curiousinventor/VMeter/Hardware/superpro_with_adapter_and_IC.jpg

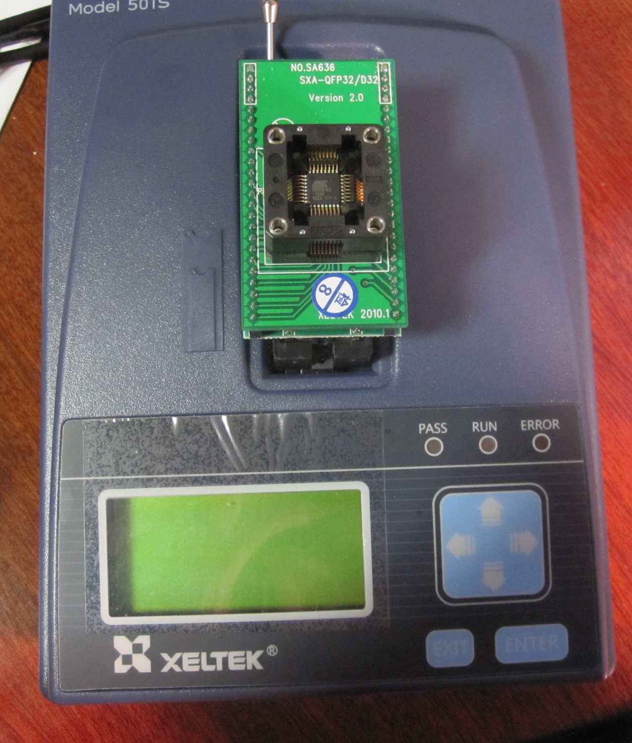
Hardware/superpro_with_adapter_and_IC.jpg
