curiousinventor/VMeter/Hardware/vmeter_fuse_settings.png

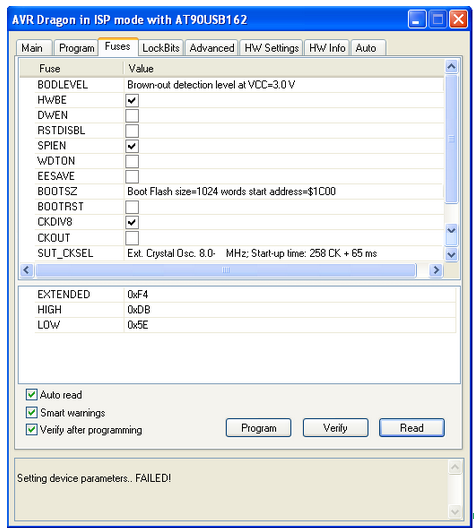
Hardware/vmeter_fuse_settings.png
