curiousinventor/VMeter/Hardware/vmeter_isp_connections.jpg

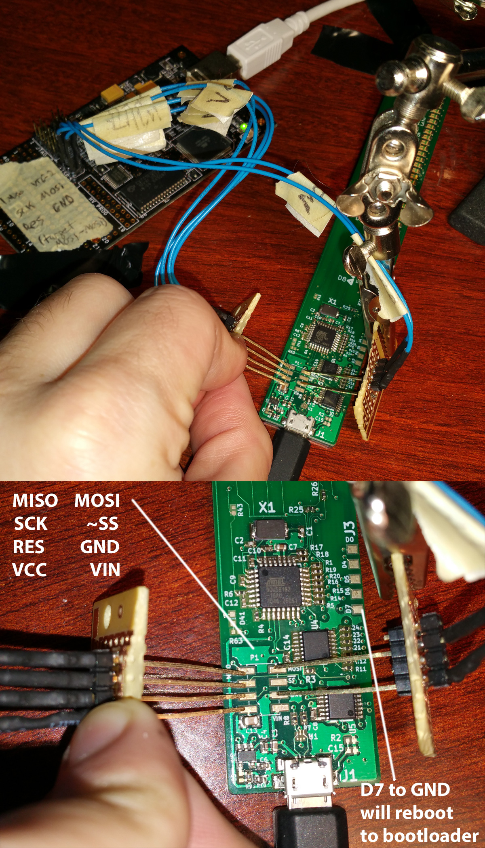
Hardware/vmeter_isp_connections.jpg
