curiousinventor/VMeter/Hardware/VMeter BOM Electrical v0.3n.xlsx

qty | desc | package | designators | dist | dist part num | man | man # | pins / part | total pins
38 | blue backfire leds | 1206 reverse | D6,D5,D3,D2,D1,D4,D7,D9,D14, D15,D16,D17,D18,D19,D20,D21, D22,D23,D24,D25,D26,D27,D28, D10,D11,D12,D40,D39,D38,D37, D36,D35,D32,D31,D30,D29,D13,D8 | digi / mouser | 754-1447-1-ND, mouser: 604-APTR3216QBC/D |  | APTR3216QBC/D | 2 | 76
2 | 8 bit shift register | 16TSSOP | U5,U4 | digikey | MC74HC595ADTR2GOSCT-ND |  | MC74HC595ADTR2G | 16 | 32
1 | AT90USB162-16AU-ND | 32-TQFP | U3 | digikey | AT90USB162-16AU-ND |  | AT90USB162-16AU | 32 | 32
7 | .1uF ceramic caps | 402 | C11,C10,C9,C8,C6,C4,C14 | digi | 311-1047-1-ND |  |  | 2 | 14
2 | 22 ohm res for USB lines | 402 | R8,R7 | digi | 311-22JRCT-ND |  |  | 2 | 4
1 | 10k resistor | 402 | R1 | digi | RMCF0402JT10K0CT-ND |  |  | 2 | 2
1 | 470k res, | 402 | R4 | digi | 311-470KJRCT-ND |  |  | 2 | 2
1 | 4.7nF, X7R important | 402 | C12 | digi | 445-1259-1-ND |  |  | 2 | 2
8 | 560 resistor | 402 | R14,R15,R16,R17,R18,R19,R20,R5 | digi | RMCF0402JT560RCT-ND |  |  | 2 | 16
1 | 10uF caps | 805 | C13 | digi | 311-1355-1-ND |  |  | 2 | 2
2 | 1uF 402 | 402 | C7,C3 | digi | 587-1454-1-ND |  |  | 2 | 4
1 | adj vreg | SOT-23 | U2 | mouser | 701-SP6201EM5-L |  | SP6201EM5-L | 5 | 5
1 | usb micro | smd | J1 | digi | H11634CT-ND, mouse: 798-ZX62-B-5PA11 |  |  | 9 | 9
1 | 8 MHz crystal, small height | smd | X1 | digi | 644-1132-1-ND, smaller version, need to update gerbers |  |  | 2 | 2
2 | 12 pF | 402 | C2,C1 | digi | 311-1016-1-ND |  |  | 2 | 4
1 | 3.48k, 1% | 402 | R10 | digikey | P3.48KLCT-ND, backup: RMCF0402FT3K48CT-ND |  |  | 2 | 2
8 | 150 ohms | 402 | R3,R11,R12,R13,R21,R22,R23,R24 |  | RMCF0402JT150RCT-ND |  |  | 2 | 16
1 | 1k | 402 | R6 |  | RMCF0402JT1K00CT-ND |  |  | 2 | 2
1 | 7.5k | 402 | R9 |  | 311-7.5KJRCT-ND |  |  | 2 | 2
14 | 3.3k | 603 | R30,R31,R32,R33,R34,R35, R36,R29,R37,R38,R39, R40,R41,R28 | digi | P3.3KGTR-ND | panasonic | ERJ-3GEYJ332V | 2 | 28
2 | 150 ohm ferrite | 402 | R25, R26 | mouser | 710-7427927115 | Wurth | 7427927115 | 2
94 | totals |  |  |  |  |  |  | total pins | 256
