curiousinventor/VMeter/Hardware/VMeter BOM Mechanical v0.3n.xlsx

desc | source | part number
assembled pcb | mfr
24x18" of gray acrylic - solar tint, trucast 2064, .060in, 48x72 cut to 24x18 nominal, | acplasticsinc.com
48x96" black acrylic sheet, 2025, .125in, cut to nominal 24x16 | acplasticsinc.com
apply transfer tape, laser cutting & silk screen (epoxy white) | laserexcel.com
3M 467MP Adhesive Transfer Tape -00-021200-68158-5 12" x 2160" | tapecase.com | 00-021200-68158-5
4ft micro USB cable | mfr
adhesive backed, rubber feet, polyurethane, 60A-70A or softer | mcmcaster | 95495K421
blister package | mfr
picture insert | mfr
barcode sticker | mfr
device FCC sticker | mfr
