curiousinventor/VMeter/Hardware/vmeter_v0-3N-1_acrylic_laser_and_silkscreen_three_layers.DXF

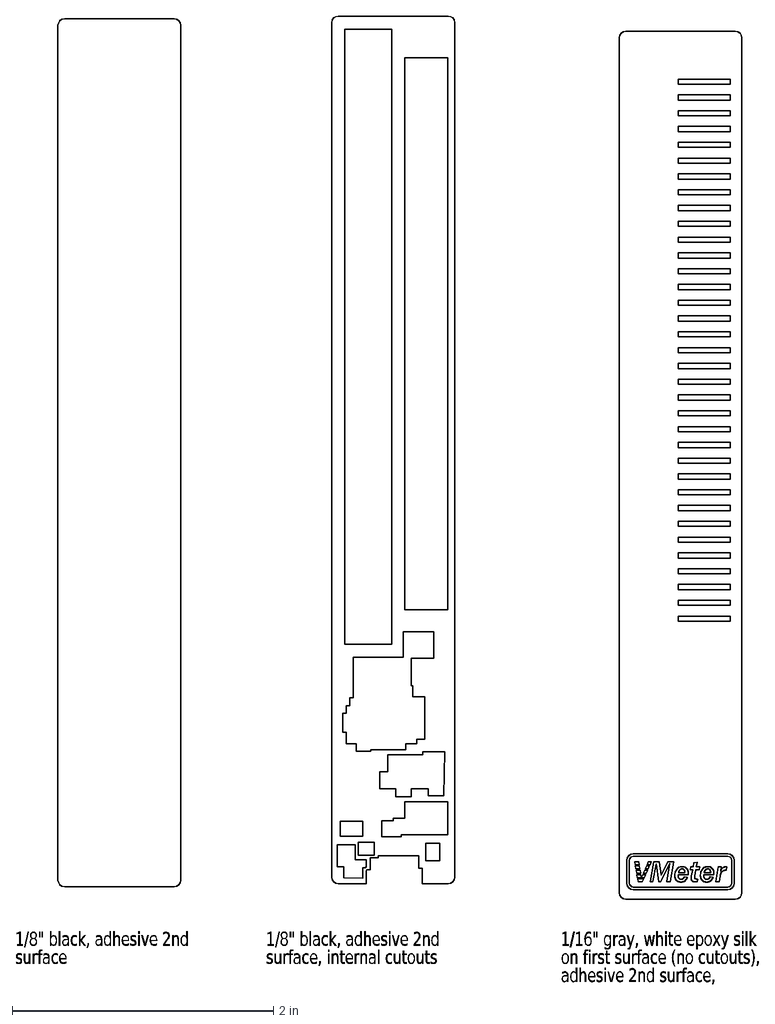
[picture p5: CAD file, 2014-12-22]
Hardware/vmeter_v0-3N-1_acrylic_laser_and_silkscreen_three_layers.DXF
1/16" gray, white epoxy silk
on first surface (no cutouts),
adhesive 2nd surface,
1/8" black, adhesive 2nd
surface, internal cutouts
surface
