curiousinventor/VMeter/Hardware/vmeter_v0-3N-1_acrylic_laser_and_silkscreen_three_layers.pdf

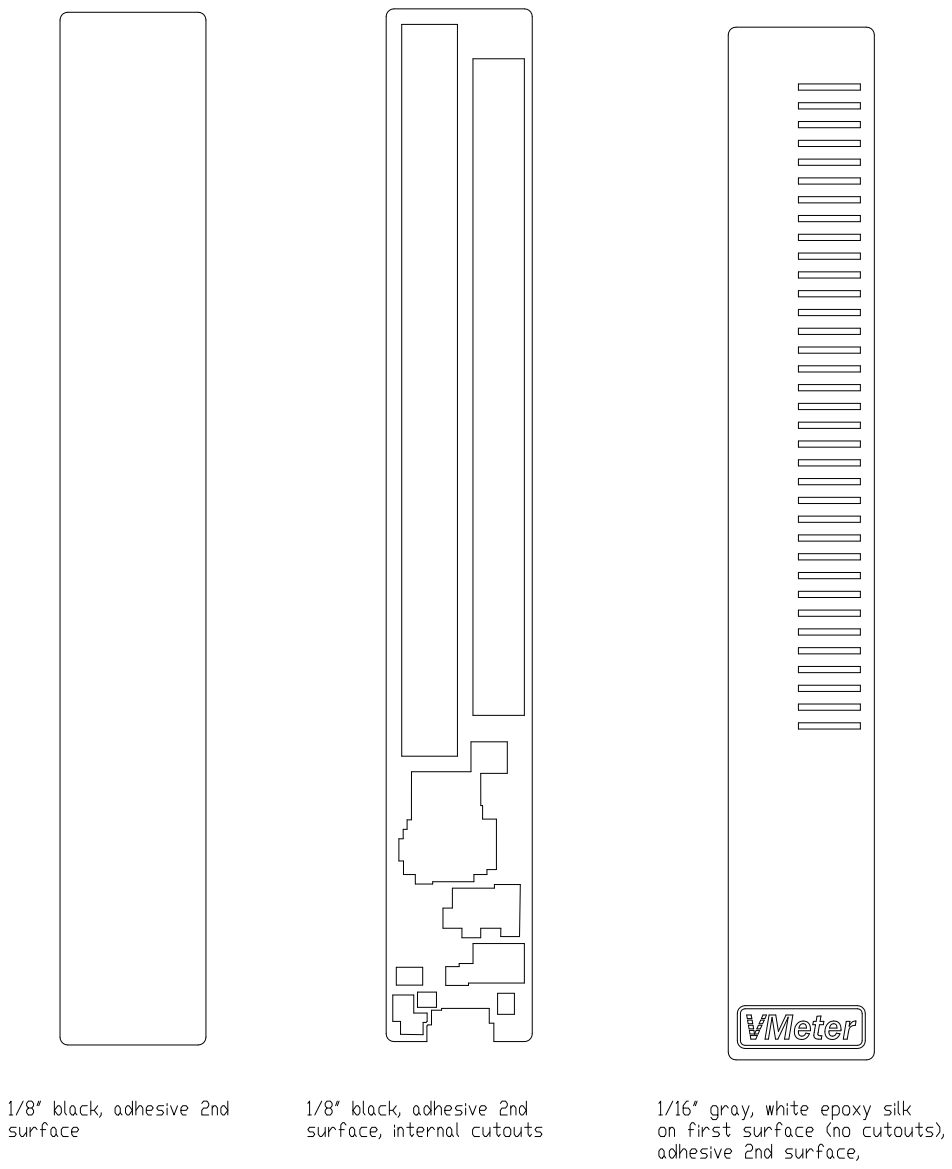
[picture p6: page 1]
