curiousinventor/VMeter/Hardware/electrical_cad_source_kicad/vmeter_v0-3n_schematic.pdf

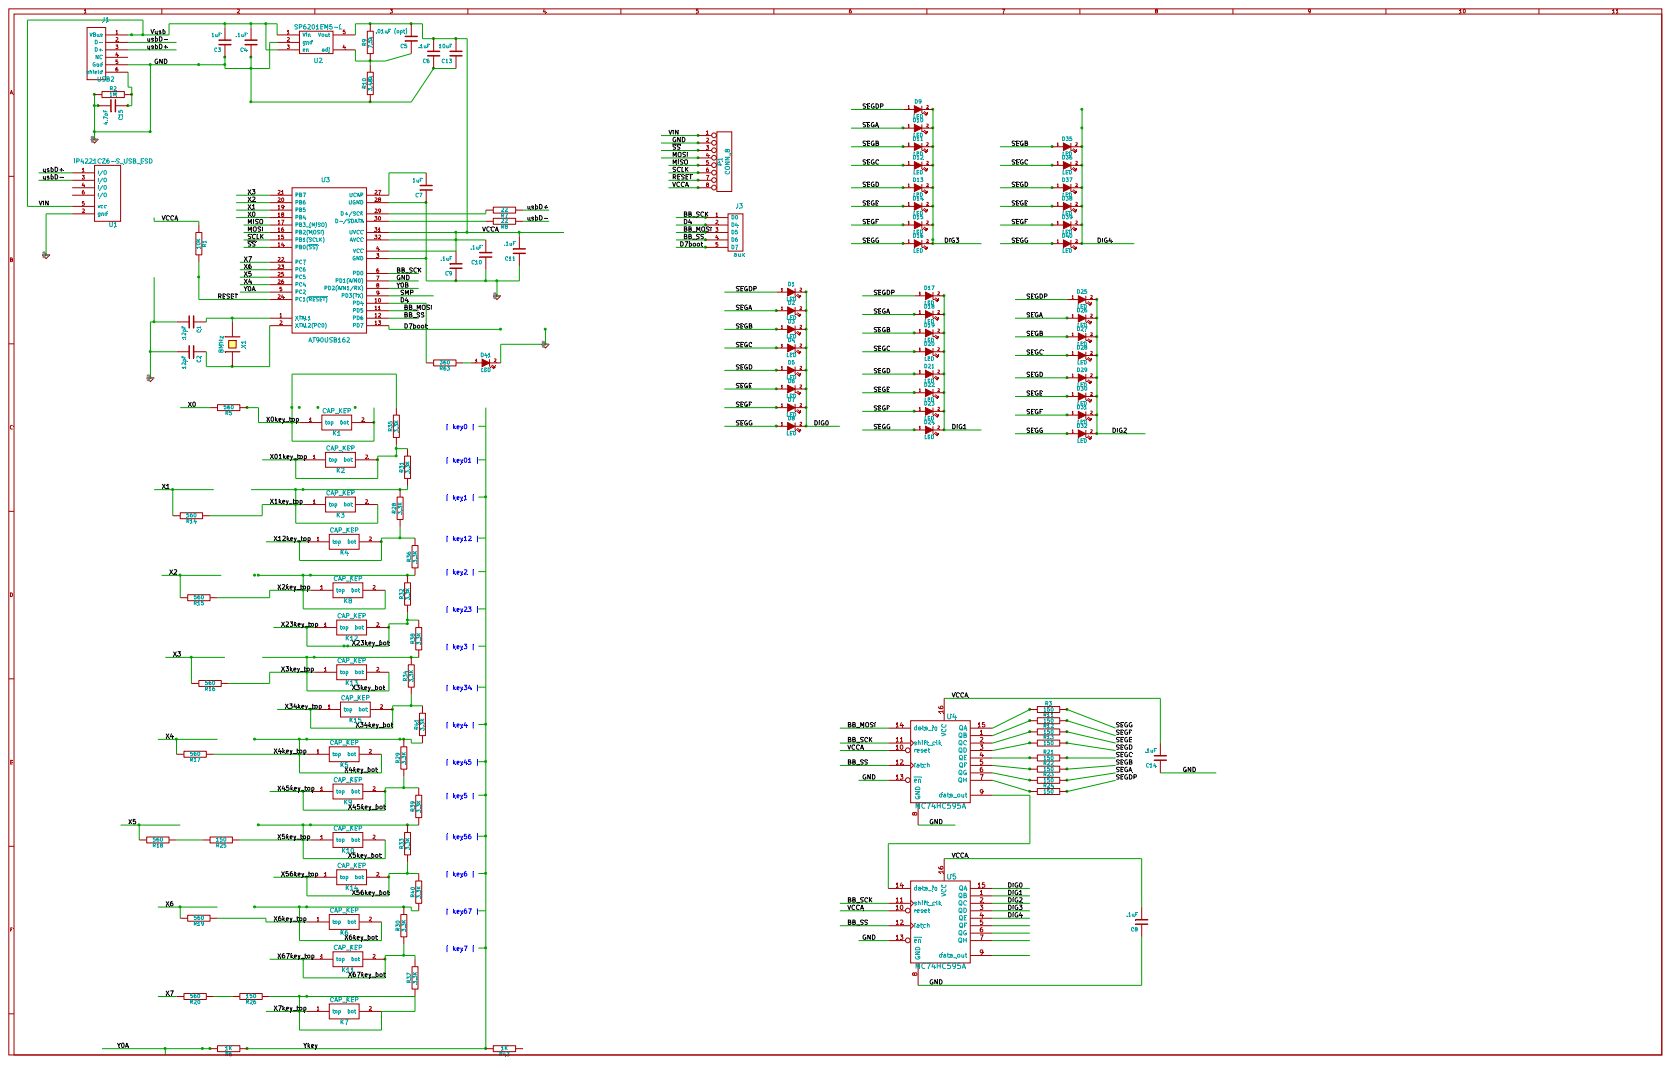
[picture p7: page 1]
