curiousinventor/VMeter/Hardware/electrical_cad_source_kicad/vol_touch.sch

## KiCad design Hardware/electrical_cad_source_kicad/vol_touch.sch (2014-12-22)

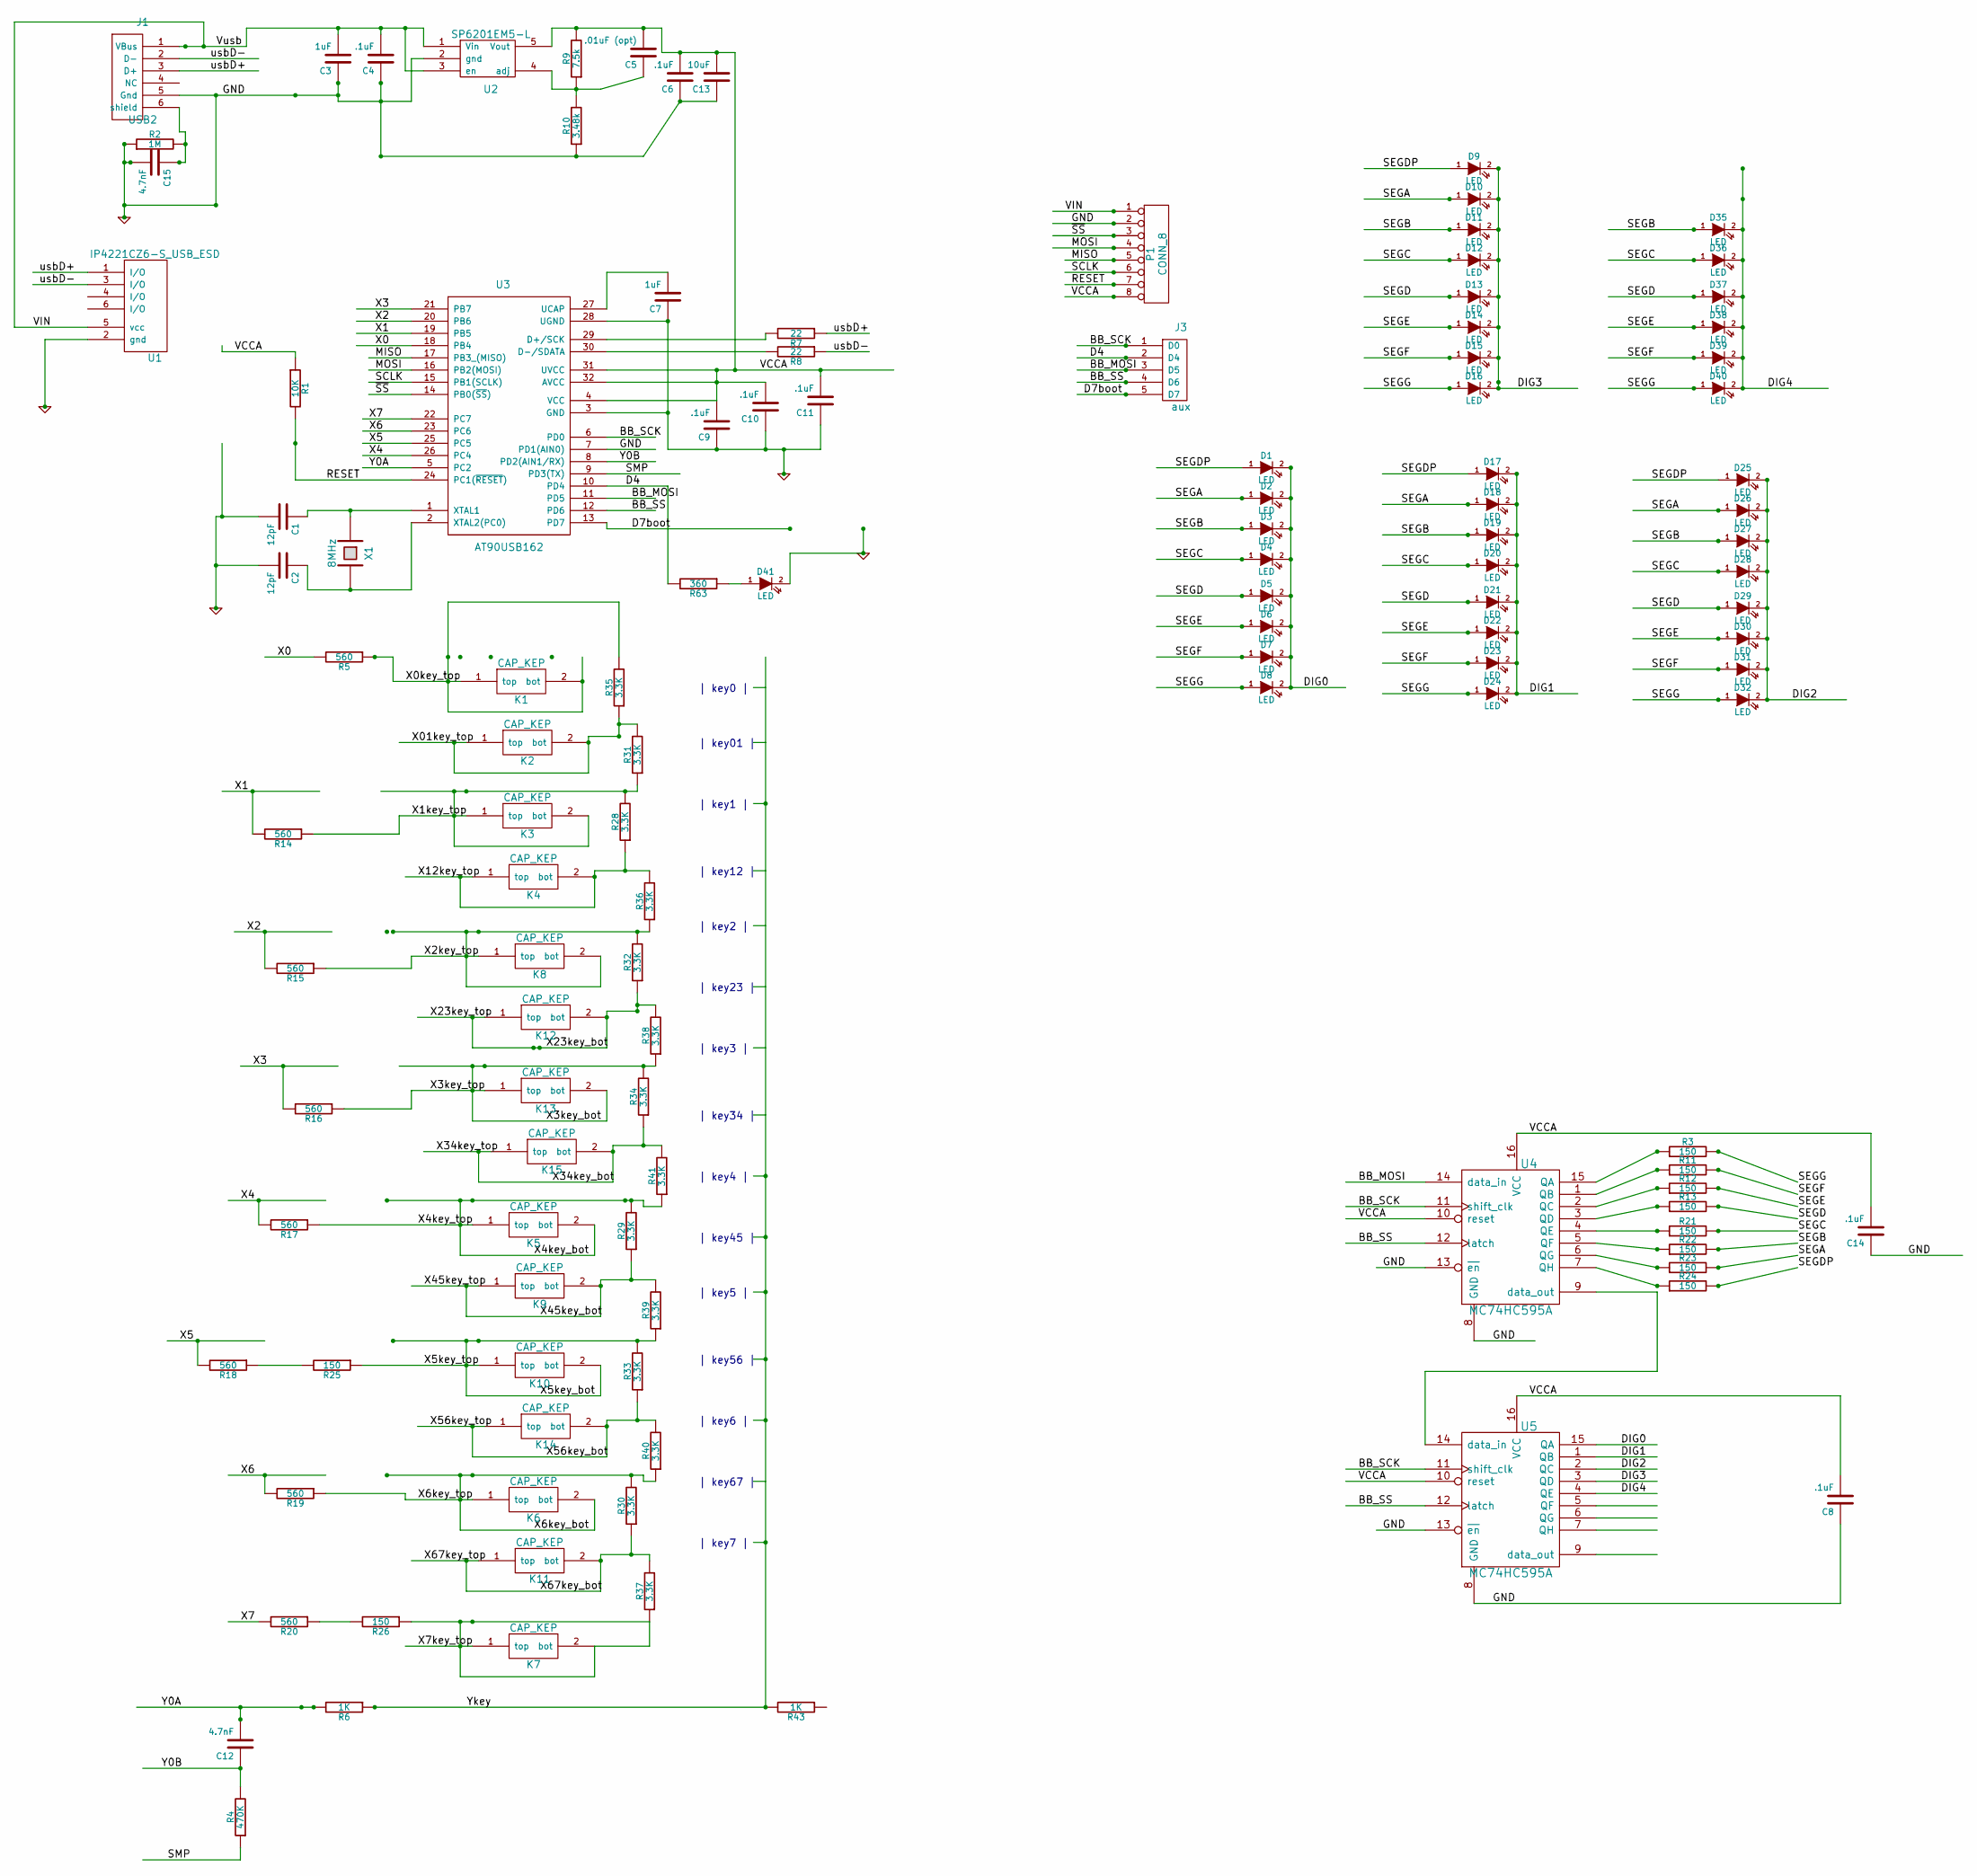
[picture p8: schematic vol_touch.sch]

Parts:
C1, C2: 12pF
C3, C7: 1uF
C4, C6, C8, C9, C10, C11, C14: .1uF
C5: .01uF (opt)
C12, C15: 4.7nF
C13: 10uF
D1, D2, D3, D4, D5, D6, D7, D8, D9, D10, D11, D12, D13, D14, D15, D16, D17, D18, D19, D20, D21, D22, D23, D24, D25, D26, D27, D28, D29, D30, D31, D32, D35, D36, D37, D38, D39, D40, D41: LED
J1: USB2
J3: aux
K1, K2, K3, K4, K5, K6, K7, K8, K9, K10, K11, K12, K13, K14, K15: CAP_KEP
P1: CONN_8
R1: 10K
R2: 1M
R3, R11, R12, R13, R21, R22, R23, R24, R25, R26: 150
R4: 470K
R5, R14, R15, R16, R17, R18, R19, R20: 560
R6, R43: 1K
R7, R8: 22
R9: 7.5k
R10: 3.48k
R28, R29, R30, R31, R32, R33, R34, R35, R36, R37, R38, R39, R40, R41: 3.3K
R63: 360
U1: IP4221CZ6-S_USB_ESD
U2: SP6201EM5-L
U3: AT90USB162
U4, U5: MC74HC595A
X1: 8MHz

Connections:
BB_MOSI: J3.3 (D5), U3.11 (PD5), U4.14 (data_in)
BB_SCK: J3.1 (D0), U3.6 (PD0), U4.11 (shift_clk), U5.11 (shift_clk)
BB_SS: J3.4 (D6), U3.12 (PD6), U4.12 (latch), U5.12 (latch)
D4: J3.2 (D4), R63.2, U3.10 (PD4)
D7boot: J3.5 (D7), U3.13 (PD7)
DIG0: D1.2 (K), D2.2 (K), D3.2 (K), D4.2 (K), D5.2 (K), D6.2 (K), D7.2 (K), D8.2 (K), U5.15 (QA)
DIG1: D17.2 (K), D18.2 (K), D19.2 (K), D20.2 (K), D21.2 (K), D22.2 (K), D23.2 (K), D24.2 (K), U5.1 (QB)
DIG2: D25.2 (K), D26.2 (K), D27.2 (K), D28.2 (K), D29.2 (K), D30.2 (K), D31.2 (K), D32.2 (K), U5.2 (QC)
DIG3: D9.2 (K), D10.2 (K), D11.2 (K), D12.2 (K), D13.2 (K), D14.2 (K), D15.2 (K), D16.2 (K), U5.3 (QD)
DIG4: D35.2 (K), D36.2 (K), D37.2 (K), D38.2 (K), D39.2 (K), D40.2 (K), U5.4 (QE)
GND: C1.2, C2.2, C3.1, C4.1, C6.1, C7.1, C8.1, C9.1, C10.1, C11.1, C13.1, C14.1, C15.2, D41.2 (K), J1.5 (Gnd), P1.2, R2.1, R10.1, U1.2 (gnd), U2.2 (gnd), U3.3 (GND), U3.7 (PD1(AIN0)), U3.28 (UGND), U4.8 (GND), U4.13 (~en), U5.8 (GND), U5.13 (~en)
MISO: P1.5, U3.17 (PB3_(MISO))
MOSI: P1.4, U3.16 (PB2(MOSI))
unnamed: C1.1, U3.1 (XTAL1), X1.1
unnamed: C2.1, U3.2 (XTAL2(PC0)), X1.2
unnamed: C5.1, R9.1, R10.2, U2.4 (adj)
unnamed: C7.2, U3.27 (UCAP)
unnamed: C15.1, J1.6 (shield), R2.2
unnamed: D41.1 (A), R63.1
unnamed: R3.1, U4.15 (QA)
unnamed: R7.2, U3.29 (D+/SCK)
unnamed: R8.2, U3.30 (D-/SDATA)
unnamed: R11.1, U4.1 (QB)
unnamed: R12.1, U4.2 (QC)
unnamed: R13.1, U4.3 (QD)
unnamed: R18.1, R25.2
unnamed: R20.1, R26.2
unnamed: R21.1, U4.4 (QE)
unnamed: R22.1, U4.5 (QF)
unnamed: R23.1, U4.6 (QG)
unnamed: R24.1, U4.7 (QH)
unnamed: U4.9 (data_out), U5.14 (data_in)
RESET: P1.7, R1.2, U3.24 (PC1(~RESET))
SCLK: P1.6, U3.15 (PB1(SCLK))
SEGA: D2.1 (A), D10.1 (A), D18.1 (A), D26.1 (A), R23.2
SEGB: D3.1 (A), D11.1 (A), D19.1 (A), D27.1 (A), D35.1 (A), R22.2
SEGC: D4.1 (A), D12.1 (A), D20.1 (A), D28.1 (A), D36.1 (A), R21.2
SEGD: D5.1 (A), D13.1 (A), D21.1 (A), D29.1 (A), D37.1 (A), R13.2
SEGDP: D1.1 (A), D9.1 (A), D17.1 (A), D25.1 (A), R24.2
SEGE: D6.1 (A), D14.1 (A), D22.1 (A), D30.1 (A), D38.1 (A), R12.2
SEGF: D7.1 (A), D15.1 (A), D23.1 (A), D31.1 (A), D39.1 (A), R11.2
SEGG: D8.1 (A), D16.1 (A), D24.1 (A), D32.1 (A), D40.1 (A), R3.2
SMP: R4.1, U3.9 (PD3(TX))
VCCA: C5.2, C6.2, C8.2, C9.2, C10.2, C11.2, C13.2, C14.2, P1.8, R1.1, R9.2, U2.5 (Vout), U3.4 (VCC), U3.31 (UVCC), U3.32 (AVCC), U4.10 (reset), U4.16 (VCC), U5.10 (reset), U5.16 (VCC)
VIN: C3.2, C4.2, J1.1 (VBus), P1.1, U1.5 (vcc), U2.1 (Vin), U2.3 (en)
X0: R5.2, U3.18 (PB4)
X0key_top: K1.1 (top), K1.2 (bot), R5.1, R35.2
X1: R14.2, U3.19 (PB5)
X1key_top: K3.1 (top), K3.2 (bot), R14.1, R28.2, R31.1
X01key_top: K2.1 (top), K2.2 (bot), R31.2, R35.1
X2: R15.2, U3.20 (PB6)
X2key_top: K8.1 (top), K8.2 (bot), R15.1, R32.2, R36.1
X3: R16.2, U3.21 (PB7)
X3key_bot: K13.1 (top), K13.2 (bot), R16.1, R34.2, R38.1
X4: R17.2, U3.26 (PC4)
X4key_bot: K5.1 (top), K5.2 (bot), R17.1, R29.2, R41.1
X5: R18.2, U3.25 (PC5)
X5key_bot: K10.1 (top), K10.2 (bot), R25.1, R33.2, R39.1
X6: R19.2, U3.23 (PC6)
X6key_bot: K6.1 (top), K6.2 (bot), R19.1, R30.2, R40.1
X7: R20.2, U3.22 (PC7)
X7key_top: K7.1 (top), K7.2 (bot), R26.1, R37.1
X12key_top: K4.1 (top), K4.2 (bot), R28.1, R36.2
X23key_bot: K12.1 (top), K12.2 (bot), R32.1, R38.2
X34key_bot: K15.1 (top), K15.2 (bot), R34.1, R41.2
X45key_bot: K9.1 (top), K9.2 (bot), R29.1, R39.2
X56key_bot: K14.1 (top), K14.2 (bot), R33.1, R40.2
X67key_bot: K11.1 (top), K11.2 (bot), R30.1, R37.2
Y0A: C12.2, R6.2, U3.5 (PC2)
Y0B: C12.1, R4.2, U3.8 (PD2(AIN1/RX))
Ykey: R6.1, R43.2
usbD+: J1.3 (D+), R7.1, U1.1 (I/O)
usbD-: J1.2 (D-), R8.1, U1.3 (I/O)
~SS: P1.3, U3.14 (PB0(~SS))

Notes on the sheet:
| key01 |
| key34 |
| key3 |
| key23 |
| key2 |
| key12 |
| key67 |
| key5 |
| key56 |
| key7 |
| key6 |
| key4 |
| key45 |
| key1 |
| key0 |
