curiousinventor/VMeter/Software/Windows_MIDI_Volume_Control/VMeter_v0/resource.h

//{{NO_DEPENDENCIES}}
// Microsoft Visual C++ generated include file.
// Used by VMeter_v0.rc
//
#define IDM_ABOUTBOX                    0x0010
#define IDD_ABOUTBOX                    100
#define IDS_ABOUTBOX                    101
#define IDD_VMETER_V0_DIALOG            102
#define IDR_VMETER_V0                   103
#define IDR_MENU1                       129
#define IDR_MENU2                       131
#define ID_VMETER_ICON                  133
#define IDD_MIDI_DEVICES_DIALOG         134
#define IDB_BITMAP1                     137
#define IDC_BUTTON1                     1000
#define IDC_BUTTON3                     1000
#define IDC_BUTTON_TEST                 1000
#define IDC_VOLUME                      1004
#define IDC_SLIDER2                     1005
#define IDC_VOL_SLIDER                  1005
#define IDC_BUTTON2                     1006
#define IDC_testhide                    1006
#define IDC_STATUS                      1008
#define IDC_BRIGHTNESS_SLIDER           1009
#define IDC_BRIGHTNESS_TEXT             1010
#define IDC_CHECK1                      1011
#define IDHIDE                          1012
#define IDC_MIDI_OUT_DEVS               1013
#define IDC_MIDI_IN_DEVS                1014
#define IDC_COMBO_MIDI_CHAN             1015
#define IDC_CHECK_POS_OUTPUT_EN         1016
#define IDC_COMBO_POS_CTRL              1017
#define IDC_CHECK_PRES_OUT_EN           1018
#define IDC_COMBO_PRES_CTRL             1019
#define IDC_CHECK_ON_OFF_EN             1020
#define IDC_STATIC_MIDI_DATA_ACTIVITY   1021
#define IDC_CHECK_RAW_OUT_EN            1022
#define IDC_CHECK_TOUCH_VOL_EN          1023
#define IDC_CHECK_MIDI_LED_EN           1024
#define IDC_CHECK_PITCH_WHEEL_EN        1025
#define IDC_CHECK_IGNORE_TOUCH          1026
#define IDC_CHECK_MIDI_BRIGHT_EN        1027
#define IDC_STATIC_MIDI_OUT             1028
#define IDC_CHECK_LED_SHOW_VOLUME_EN    1029
#define IDC_BUTTON4                     1029
#define IDC_COMBO_ON_OFF_CTRL           1030
#define IDC_COMBO_LED_MIDI_POS_CTRL     1031
#define IDC_RADIO1                      1031
#define IDC_COMBO_LED_BRIGHT_CTRL       1032
#define IDC_RADIO2                      1032
#define IDC_COMBO_RAW_MIN               1033
#define IDC_CHECK2                      1033
#define IDC_STATIC_MIDI_IN              1034
#define IDC_RADIO3                      1034
#define IDC_CPU_RADIO                   1034
#define IDC_COMBO_RAW_MAX               1036
#define IDC_COMBO_PRES_MAX              1037
#define IDC_COMBO_PRES_MIN              1038
#define ID_FILE_EXIT                    32771
#define ID_TOOLS_UPDATEFIRMWARE         32772
#define ID_TOOLS_RECALIBRATE            32773
#define ID_TOOLS_RECORDDEBUGFILE        32774
#define ID_HELP_ABOUT                   32775
#define ID_HELP_OPENWEBSITEHELP         32776
#define ID__SHOW                        32777
#define ID__HIDE                        32778
#define ID__EXIT                        32779
#define ID_                             32780
#define ID__EMPTYMENUITEM               32781
#define ID__HIDE32782                   32782
#define ID__QUIT                        32783
#define ID__SHOWMENUITEM                32784
#define ID__HIDEMENUITEM                32785
#define ID_Menu                         32786
#define ID__TESTCAPTION                 32788
#define ID__TEST2                       32789
#define ID_EDIT_MIDIDEVICEROUTING       32790
#define ID_TOOLS_LOADDEFAULTS           32791

// Next default values for new objects
// 
#ifdef APSTUDIO_INVOKED
#ifndef APSTUDIO_READONLY_SYMBOLS
#define _APS_NEXT_RESOURCE_VALUE        139
#define _APS_NEXT_COMMAND_VALUE         32792
#define _APS_NEXT_CONTROL_VALUE         1035
#define _APS_NEXT_SYMED_VALUE           104
#endif
#endif
