curiousinventor/VMeter/Software/Windows_MIDI_Volume_Control/VMeter_v0/SoundC.h

#include "stdafx.h"
#include <mmdeviceapi.h>
#include <endpointvolume.h>

void SetMasterVolume(float v);
float GetMasterVolume();
void CloseMixer();
void releaseEndPointVolumeForVista();
void getVolumeEndPointVolumeForVista();
BOOL IsVistaOrLater();
