curiousinventor/VMeter/Software/firmware_eeprom_writer/MIDI_eeprom.h

unsigned int MIDI_eeprom_size=214;
unsigned char MIDI_eeprom[] = {
0x02,0x00,0x14,0x11,0x12,0x14,0x15,0x40,0x64,0x64,0x00,0x00,0x08,0x40,0x06,
0x12,0x01,0x10,0x01,0x00,0x00,0x00,0x08,0xd0,0x16,0x68,0x06,0x30,0x01,0x01,
0x02,0xdc,0x01,0x09,0x02,0x65,0x00,0x02,0x01,0x00,0xc0,0x32,0x09,0x04,0x00,
0x00,0x00,0x01,0x01,0x00,0x00,0x09,0x24,0x01,0x00,0x01,0x09,0x00,0x01,0x01,
0x09,0x04,0x01,0x00,0x02,0x01,0x03,0x00,0x00,0x07,0x24,0x01,0x00,0x01,0x41,
0x00,0x06,0x24,0x02,0x01,0x01,0x00,0x06,0x24,0x02,0x02,0x02,0x00,0x09,0x24,
0x03,0x01,0x03,0x01,0x02,0x01,0x00,0x09,0x24,0x03,0x02,0x04,0x01,0x01,0x01,
0x00,0x09,0x05,0x01,0x02,0x40,0x00,0x01,0x00,0x00,0x05,0x25,0x01,0x01,0x01,
0x09,0x05,0x82,0x02,0x40,0x00,0x01,0x00,0x00,0x05,0x25,0x01,0x01,0x03,0x04,
0x03,0x09,0x04,0x2c,0x03,0x43,0x00,0x75,0x00,0x72,0x00,0x69,0x00,0x6f,0x00,
0x75,0x00,0x73,0x00,0x20,0x00,0x49,0x00,0x6e,0x00,0x76,0x00,0x65,0x00,0x6e,
0x00,0x74,0x00,0x6f,0x00,0x72,0x00,0x2c,0x00,0x20,0x00,0x4c,0x00,0x4c,0x00,
0x43,0x00,0x00,0x00,0x1c,0x03,0x56,0x00,0x4d,0x00,0x65,0x00,0x74,0x00,0x65,
0x00,0x72,0x00,0x20,0x00,0x31,0x00,0x2e,0x00,0x33,0x00,0x30,0x00,0x20,0x00,
0x30,0x00,0x00,0x00
};
