curiousinventor/VMeter/(commit log)

2014-12-22 added pic of AVR Studio fuse settings
2014-12-22 added full firmware + bootloader and FUSE settings file for AVR studio.
2014-12-22 added hardware source and production files, including kicad source, schematic, gerbers, laser cut and silk screen outlines, BOMs
    [VMeter 0-3N PCB BOM.xlsx, VMeter BOM Electrical v0.3n.xlsx, VMeter BOM Mechanical v0.3n.xlsx, vmeter_v0-3N-1_acrylic_laser_and_silkscreen_three_layers.DXF, vol_touch.brd, vol_touch.csv, vol_touch.sch, vol_touch_2.brd]
2015-01-25 added arduino usb host demo and instructions, added video to python readme.
